raaulalonso/caseback/hardware/mechanical/renders/disc_puck_section.jpg

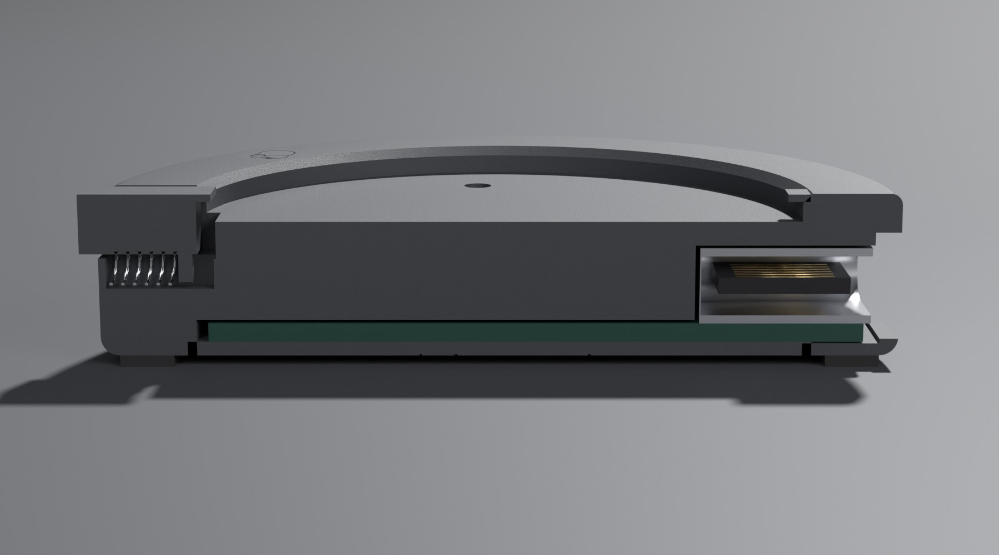
hardware/mechanical/renders/disc_puck_section.jpg
