raaulalonso/caseback/hardware/mechanical/renders/board_skin.jpg

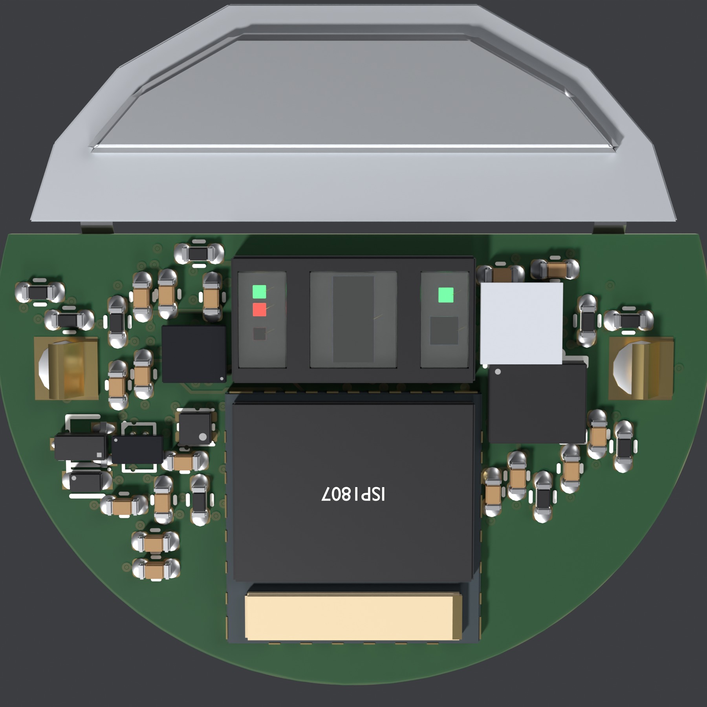
hardware/mechanical/renders/board_skin.jpg
