raaulalonso/caseback/apps/android/README.md

# Caseback Android (V2)

Native Android app (Kotlin + Jetpack Compose + Health Connect).

Out of scope for M0–M4. The iOS app is the V1 client. This package will consume `caseback-protocol` bindings.
