raaulalonso/caseback/hardware/mechanical/renders/band_buckle.jpg

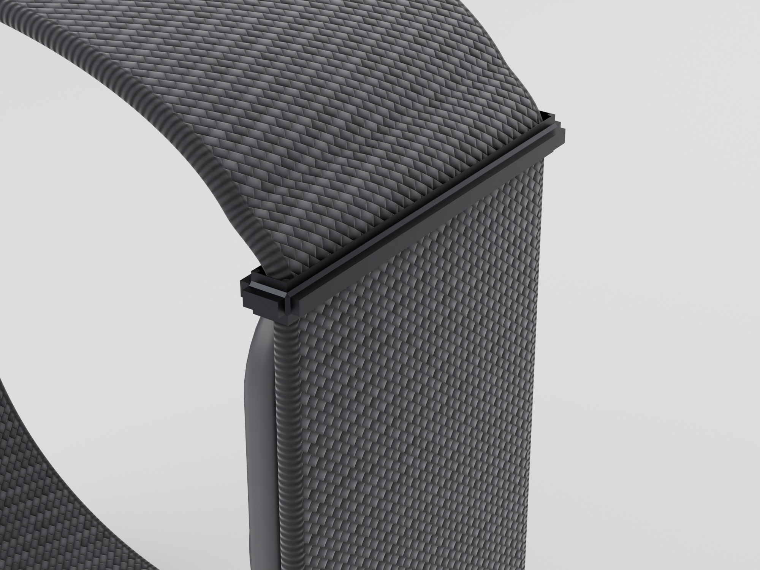
hardware/mechanical/renders/band_buckle.jpg
