raaulalonso/caseback/hardware/mechanical/renders/band_charging.jpg

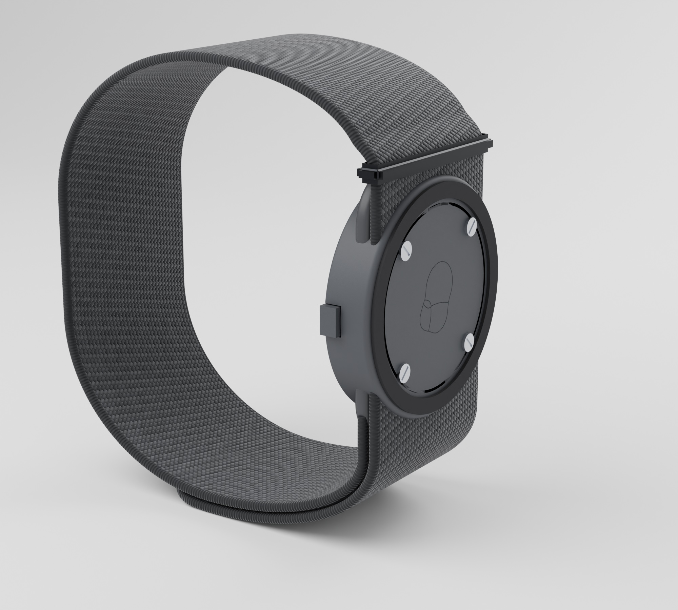
hardware/mechanical/renders/band_charging.jpg
