raaulalonso/caseback/hardware/mechanical/renders/band_hero.jpg

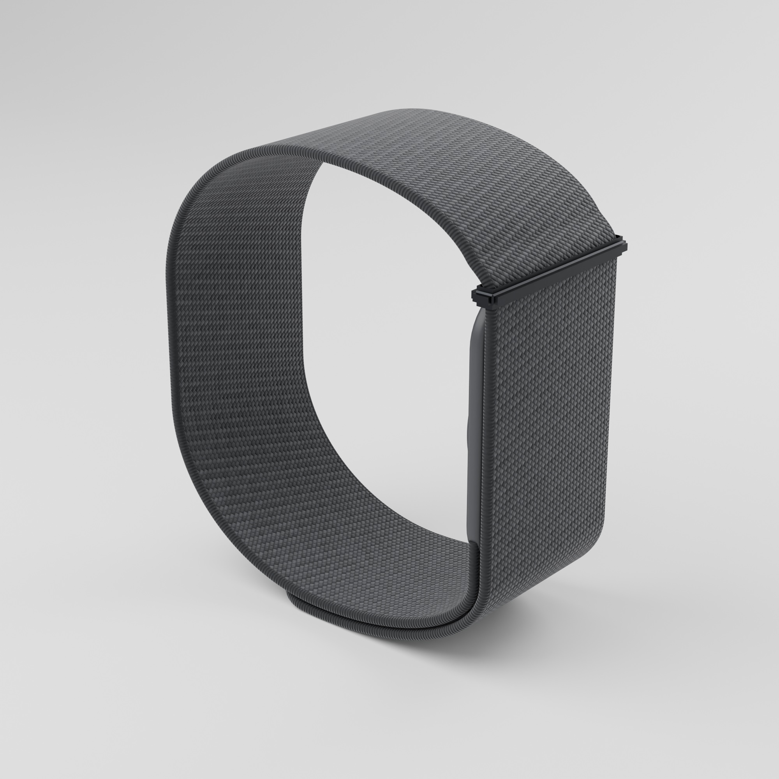
hardware/mechanical/renders/band_hero.jpg
