raaulalonso/caseback/hardware/mechanical/renders/band_holder.jpg

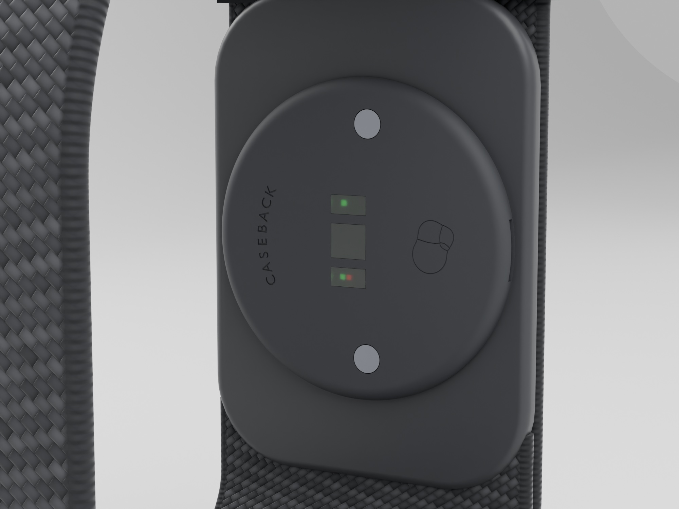
hardware/mechanical/renders/band_holder.jpg
