raaulalonso/caseback/hardware/mechanical/renders/band_inside.jpg

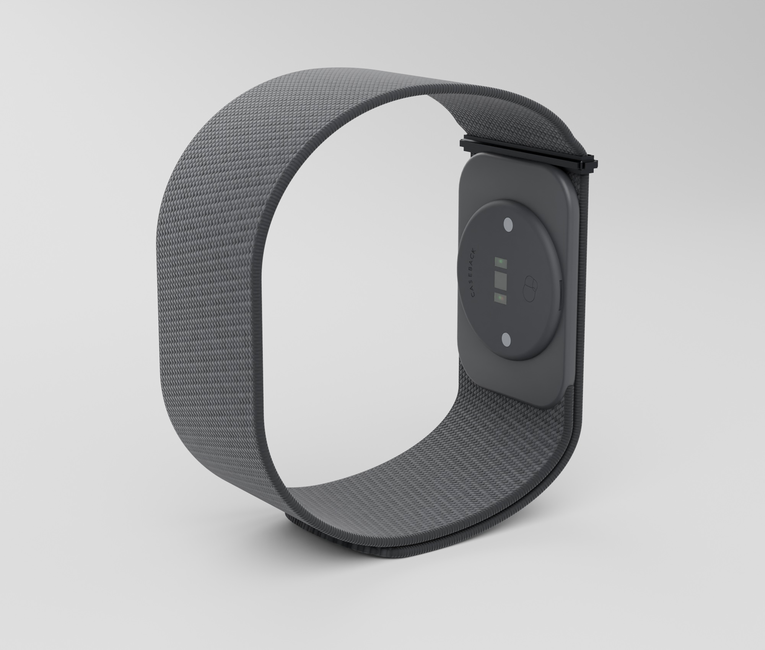
hardware/mechanical/renders/band_inside.jpg
