raaulalonso/caseback/hardware/mechanical/renders/band_open.jpg

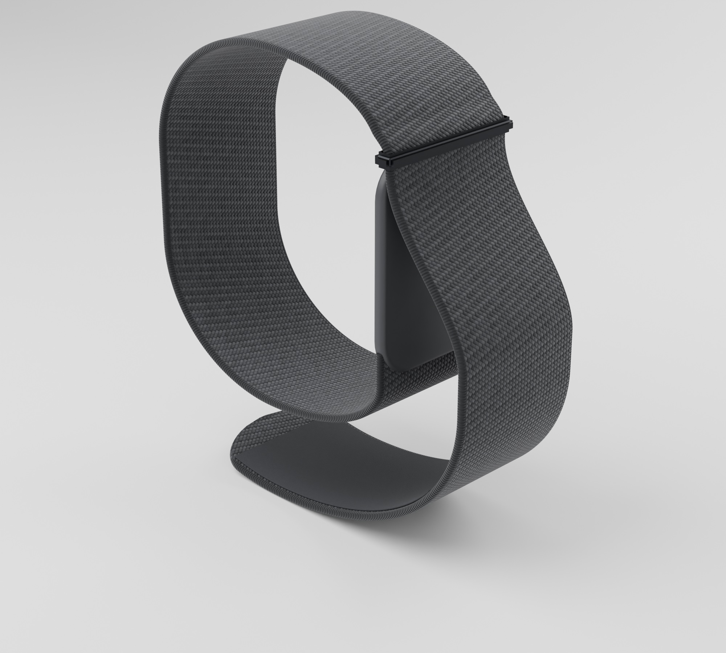
hardware/mechanical/renders/band_open.jpg
