raaulalonso/caseback/hardware/mechanical/renders/board_detail.jpg

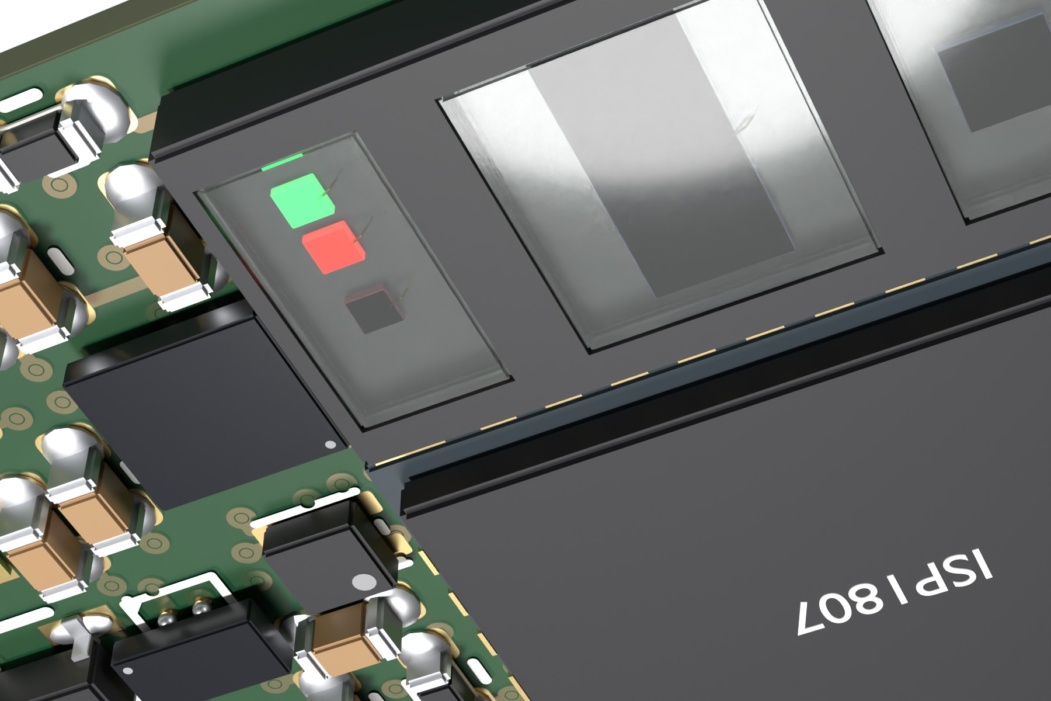
hardware/mechanical/renders/board_detail.jpg
