raaulalonso/caseback/hardware/mechanical/renders/board_oblique.jpg

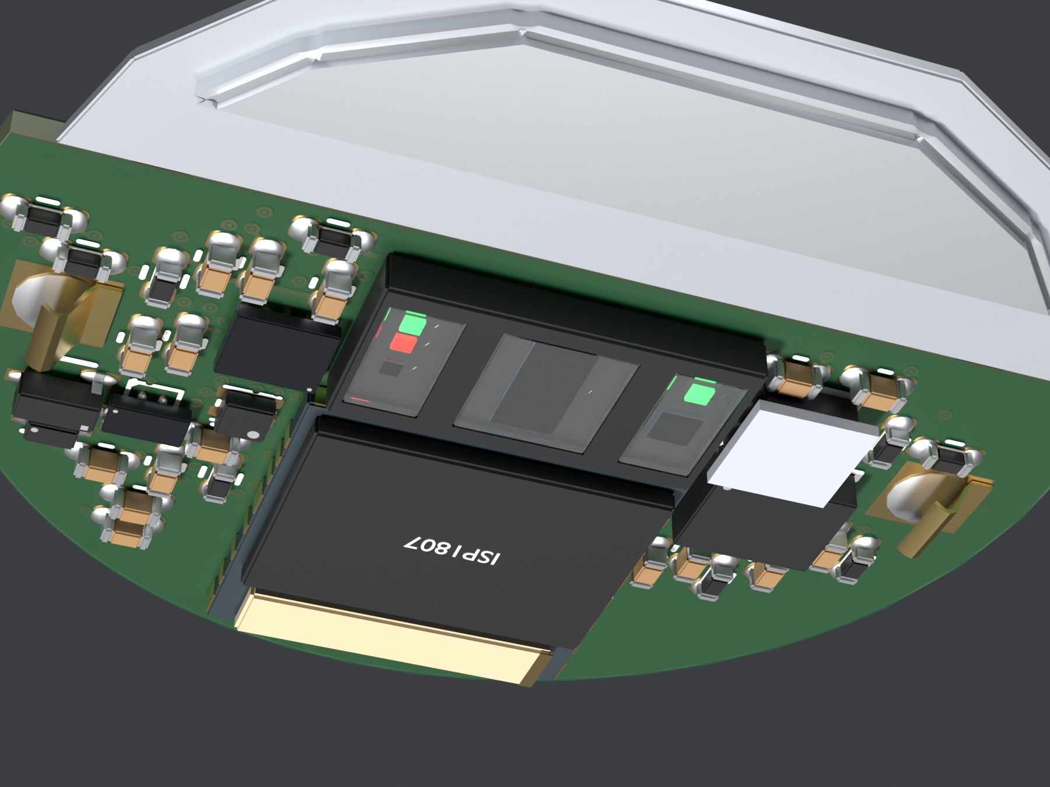
hardware/mechanical/renders/board_oblique.jpg
