raaulalonso/caseback/hardware/mechanical/renders/board_watch.jpg

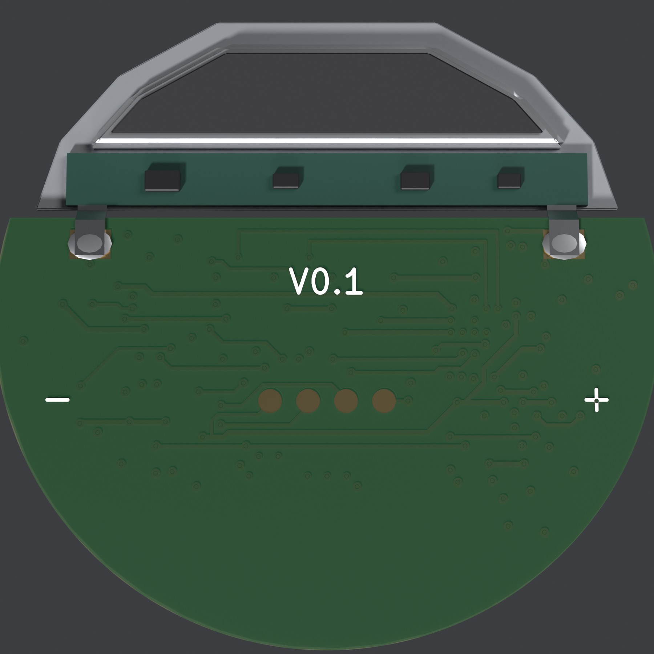
hardware/mechanical/renders/board_watch.jpg
