raaulalonso/caseback/hardware/mechanical/renders/disc_contact_section.jpg

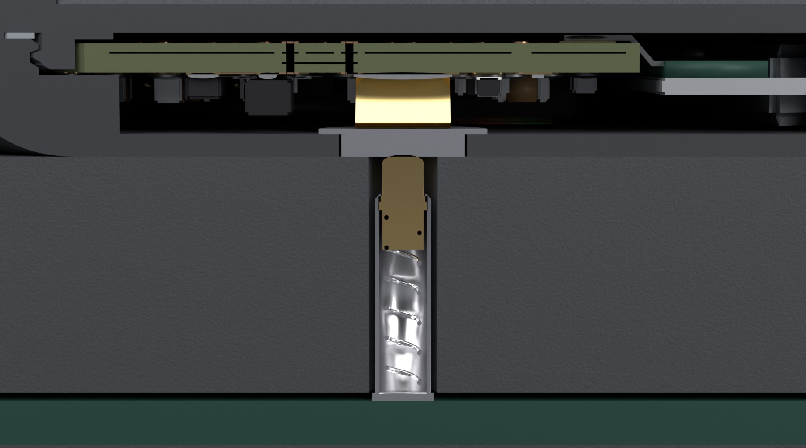
hardware/mechanical/renders/disc_contact_section.jpg
