raaulalonso/caseback/hardware/mechanical/renders/disc_docked.jpg

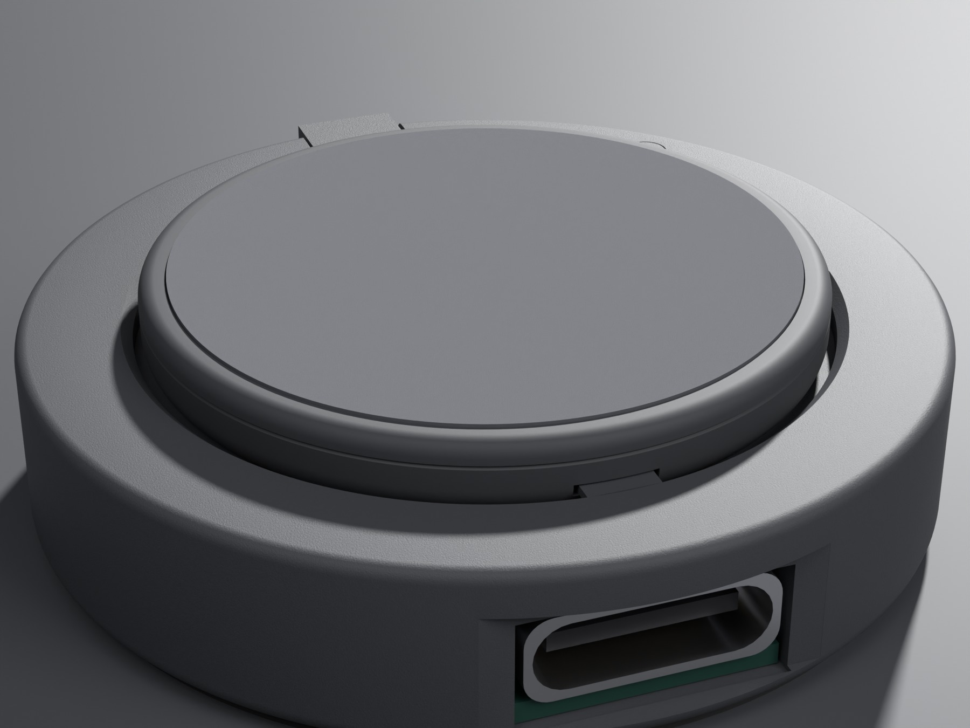
hardware/mechanical/renders/disc_docked.jpg
