raaulalonso/caseback/hardware/mechanical/renders/disc_docked_section.jpg

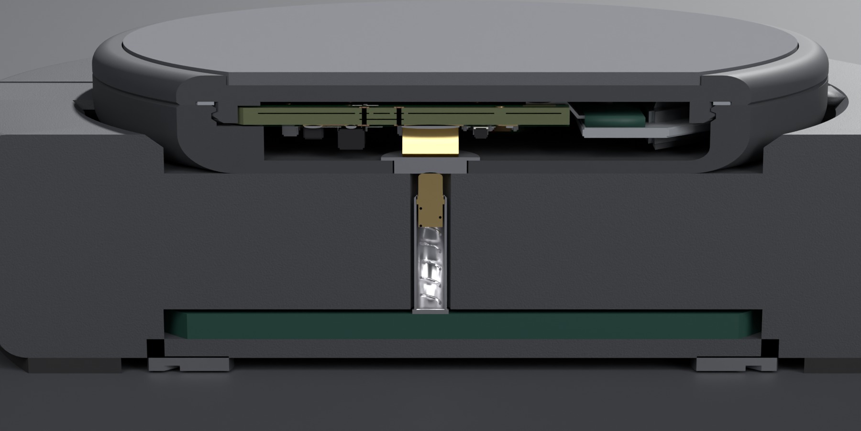
hardware/mechanical/renders/disc_docked_section.jpg
