raaulalonso/caseback/hardware/mechanical/renders/disc_edge.jpg

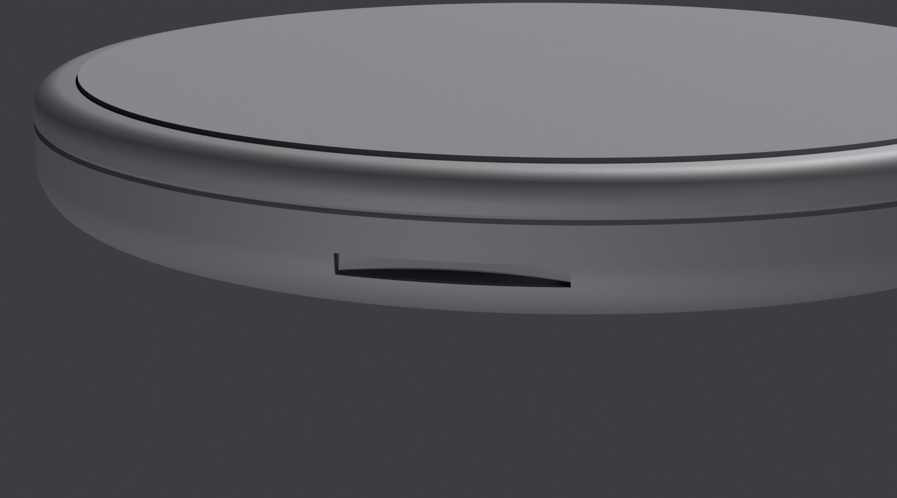
hardware/mechanical/renders/disc_edge.jpg
