raaulalonso/caseback/hardware/mechanical/renders/disc_edge_section.jpg

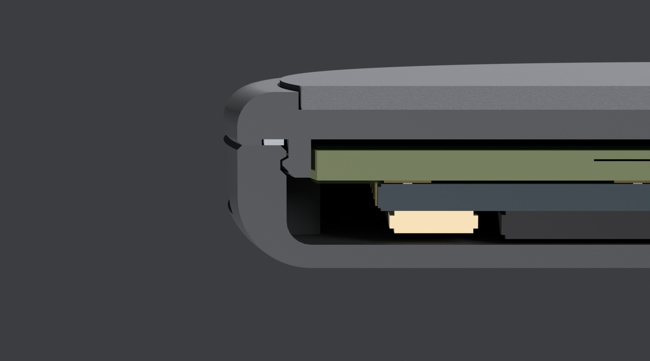
hardware/mechanical/renders/disc_edge_section.jpg
