raaulalonso/caseback/hardware/mechanical/renders/disc_exploded.jpg

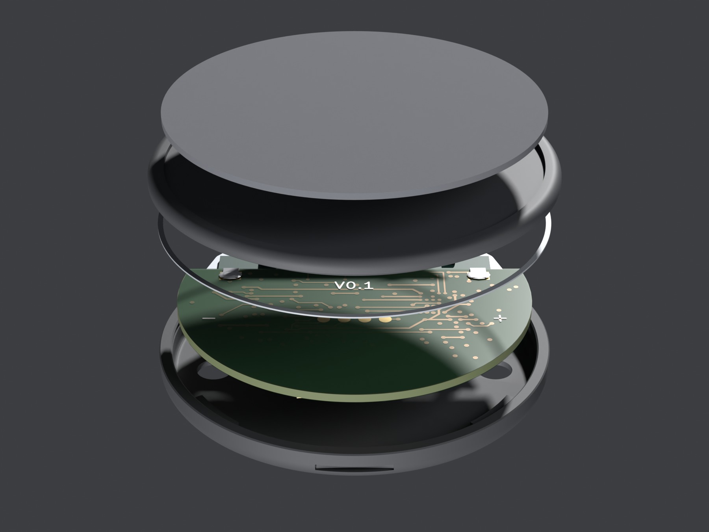
hardware/mechanical/renders/disc_exploded.jpg
