raaulalonso/caseback/hardware/mechanical/renders/disc_puck.jpg

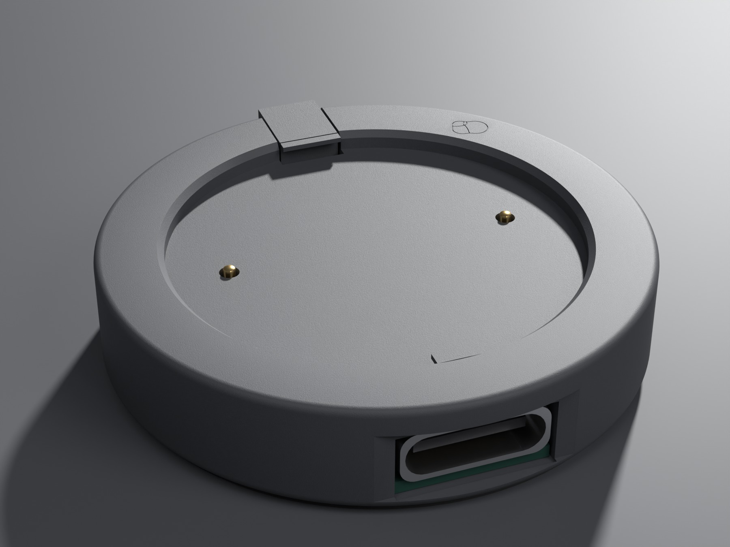
hardware/mechanical/renders/disc_puck.jpg
