raaulalonso/caseback/hardware/mechanical/renders/disc_puck_usb.jpg

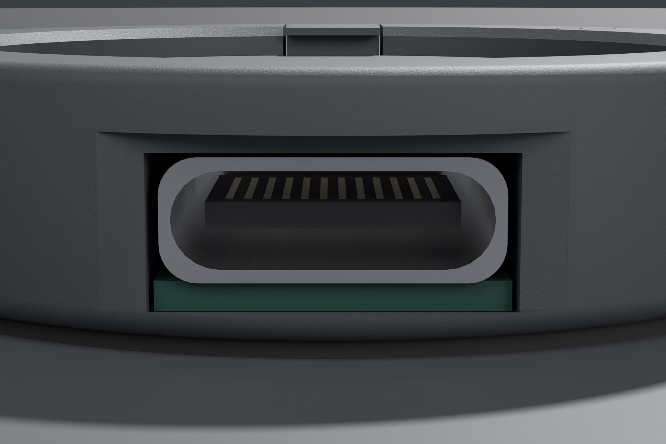
hardware/mechanical/renders/disc_puck_usb.jpg
