raaulalonso/caseback/hardware/mechanical/renders/disc_section.jpg

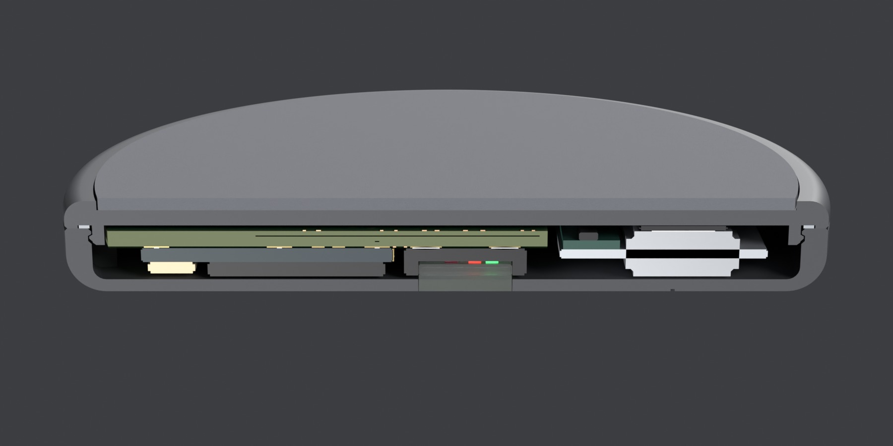
hardware/mechanical/renders/disc_section.jpg
