raaulalonso/caseback/hardware/mechanical/renders/disc_skin_contacts.jpg

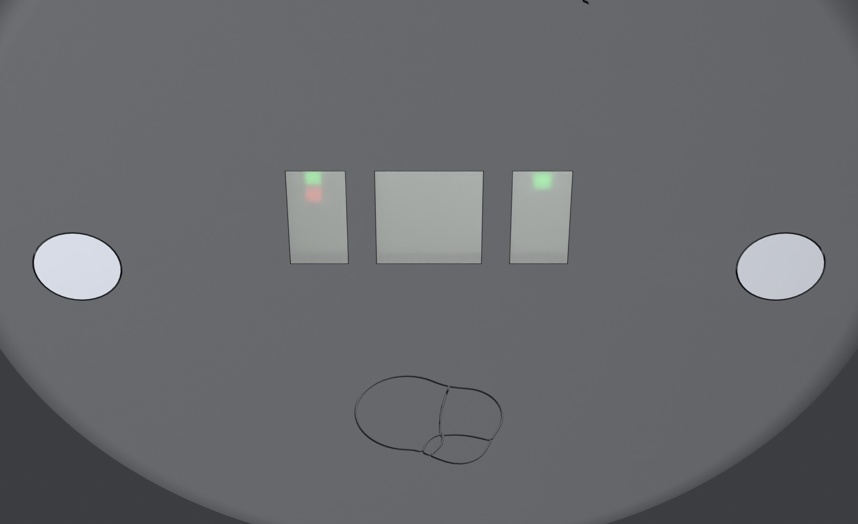
hardware/mechanical/renders/disc_skin_contacts.jpg
