raaulalonso/caseback/hardware/mechanical/renders/disc_skin_side.jpg

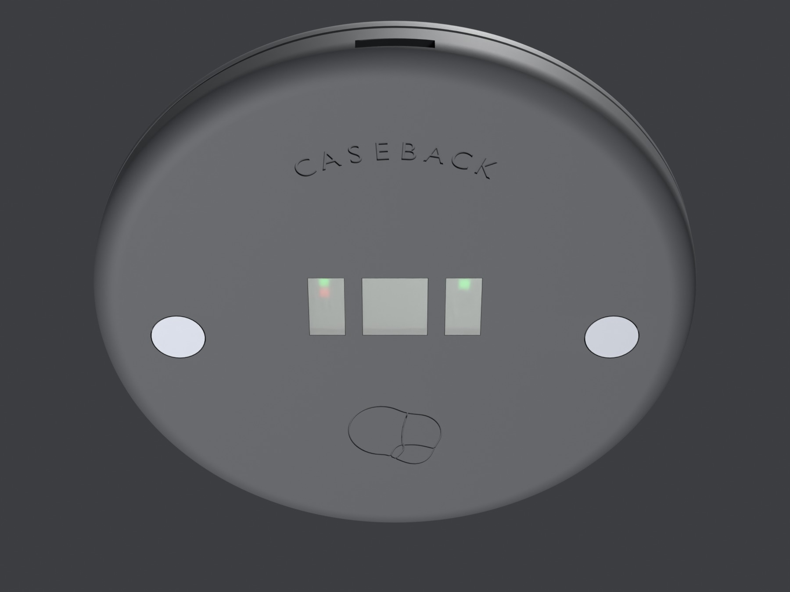
hardware/mechanical/renders/disc_skin_side.jpg
