raaulalonso/caseback/hardware/mechanical/renders/disc_watch_side.jpg

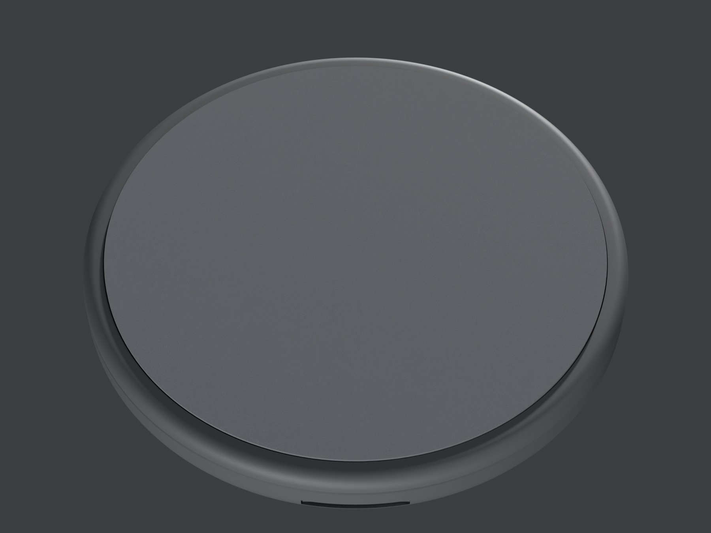
hardware/mechanical/renders/disc_watch_side.jpg
