raaulalonso/caseback/hardware/mechanical/renders/v1_exploded.png

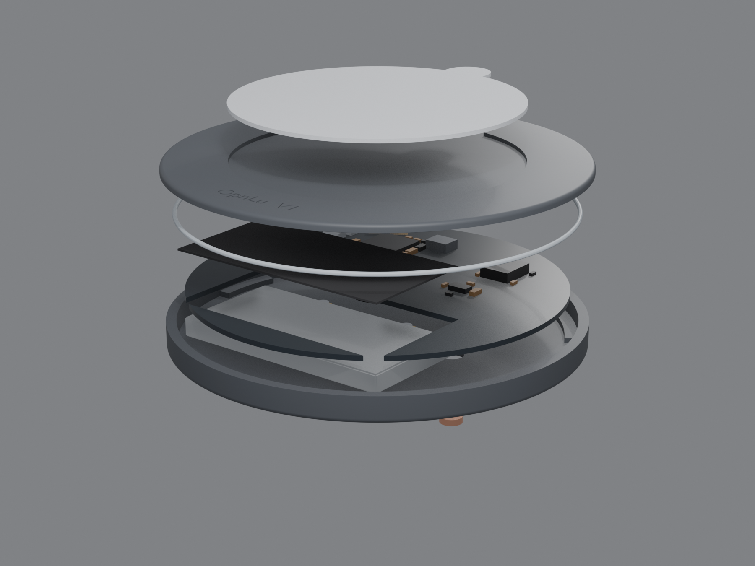
hardware/mechanical/renders/v1_exploded.png
