raaulalonso/caseback/hardware/mechanical/renders/v1_inside.png

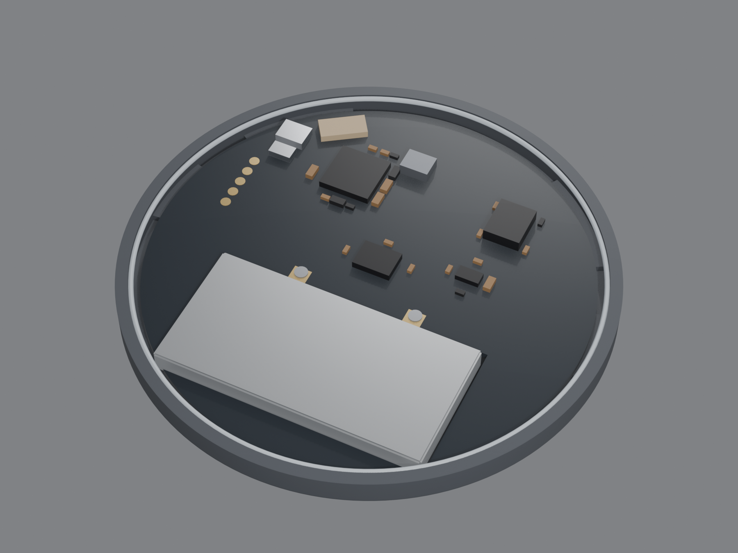
hardware/mechanical/renders/v1_inside.png
