raaulalonso/caseback/hardware/mechanical/renders/v1_section.png

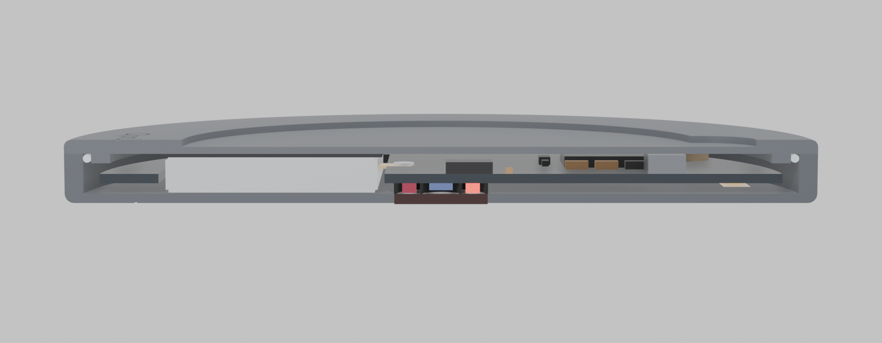
hardware/mechanical/renders/v1_section.png
