raaulalonso/caseback/hardware/mechanical/renders/v1_skin_side.png

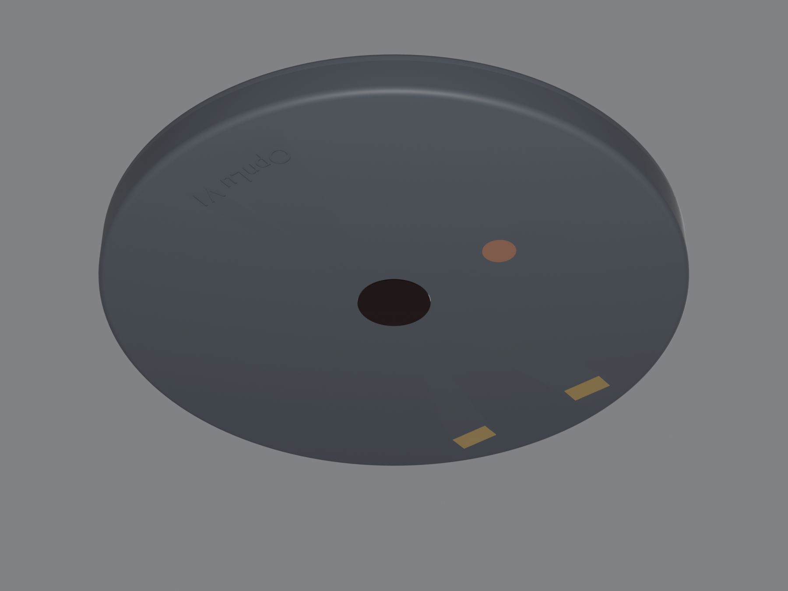
hardware/mechanical/renders/v1_skin_side.png
