raaulalonso/caseback/hardware/mechanical/renders/v1_watch_side.png

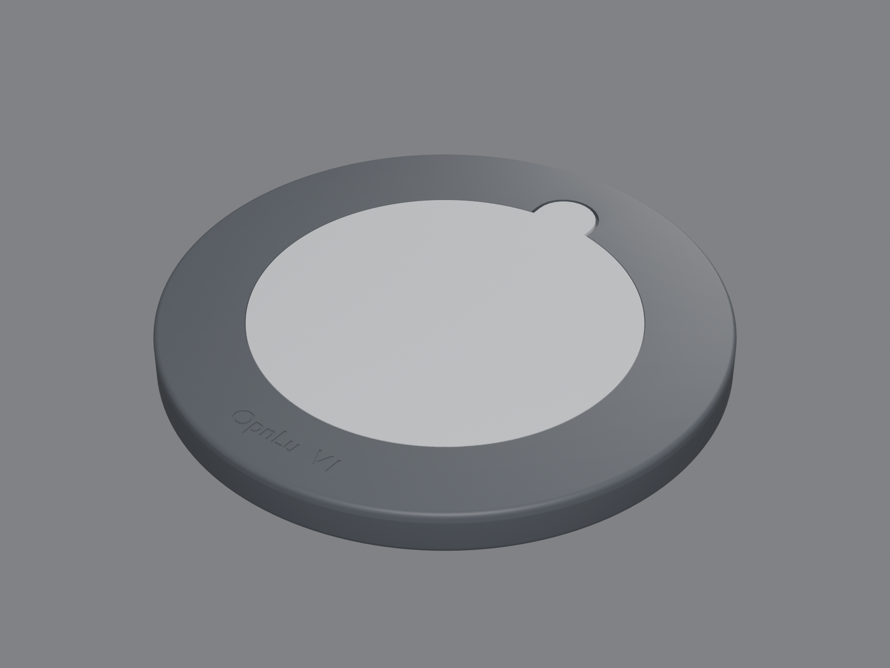
hardware/mechanical/renders/v1_watch_side.png
