raaulalonso/caseback/hardware/v1-pcb/drawings/board_v01_skin.png

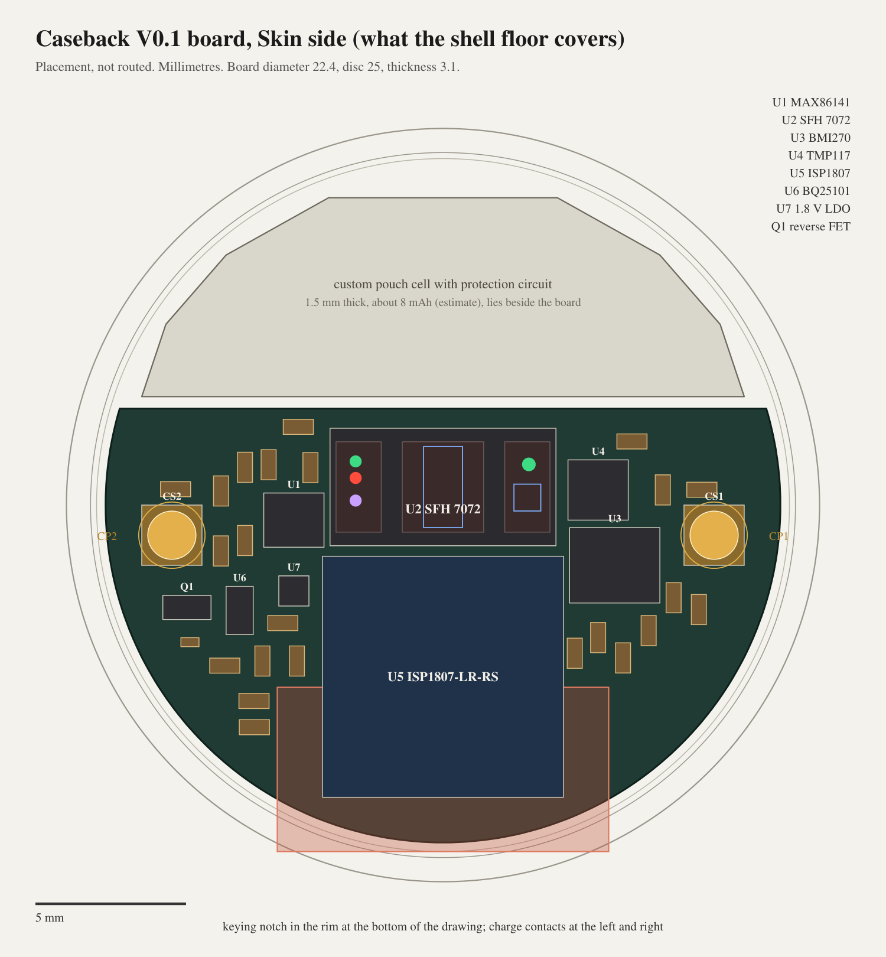
hardware/v1-pcb/drawings/board_v01_skin.png
