raaulalonso/caseback/hardware/v1-pcb/drawings/board_v01_watch.png

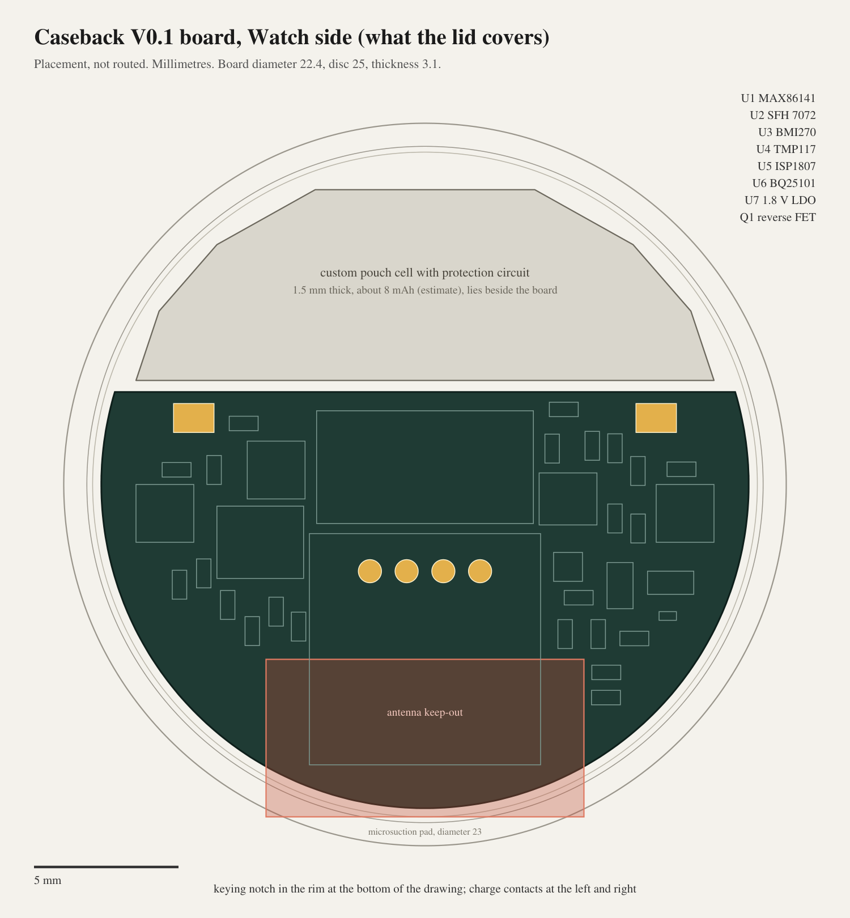
hardware/v1-pcb/drawings/board_v01_watch.png
