raaulalonso/caseback/hardware/v1-pcb/drawings/pcb_v01_skin.png

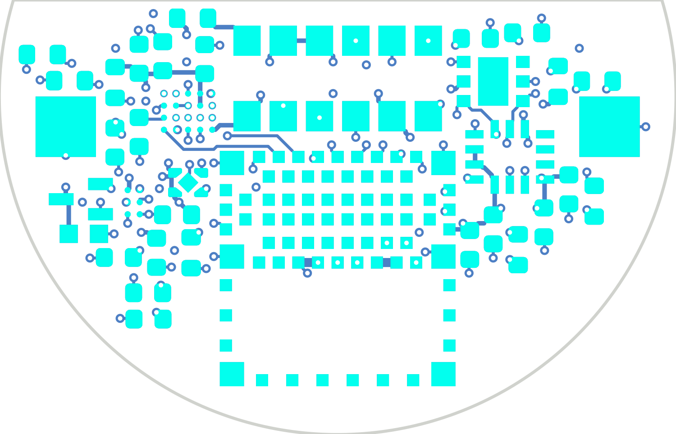
hardware/v1-pcb/drawings/pcb_v01_skin.png
