raaulalonso/caseback/hardware/v1-pcb/drawings/pcb_v01_watch.png

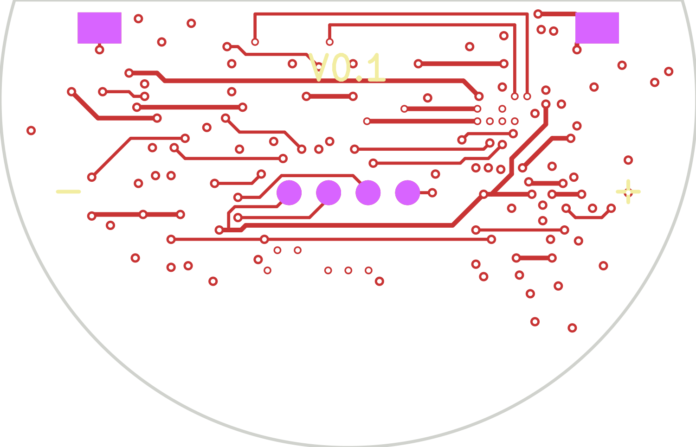
hardware/v1-pcb/drawings/pcb_v01_watch.png
