raaulalonso/caseback/hardware/v1-pcb/drawings/stack_v01.png

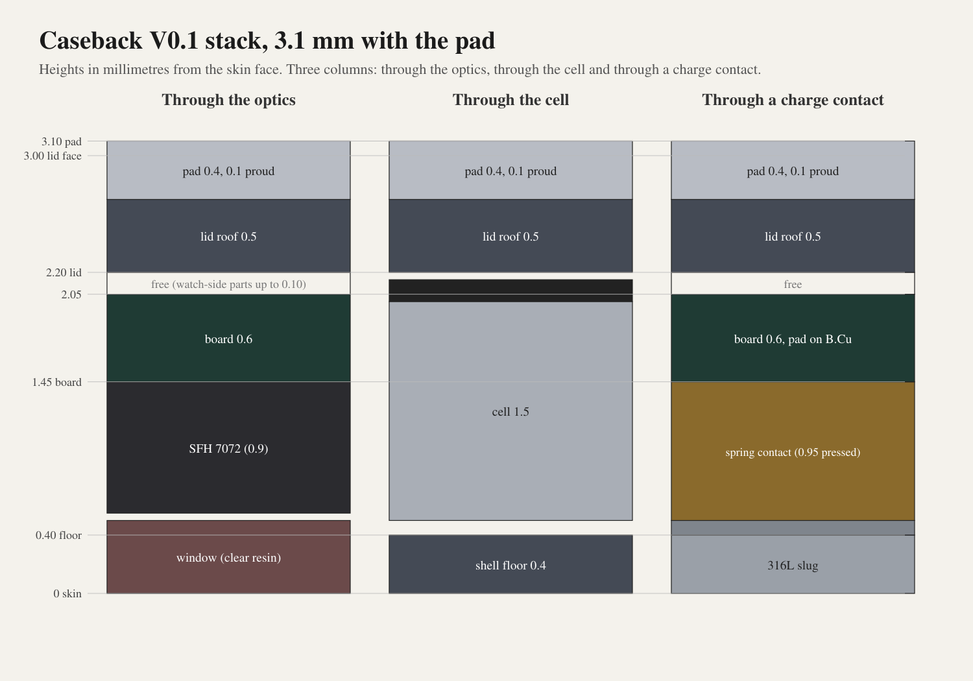
hardware/v1-pcb/drawings/stack_v01.png
