raaulalonso/caseback/tools/watch3d/leather_grain_normal.png

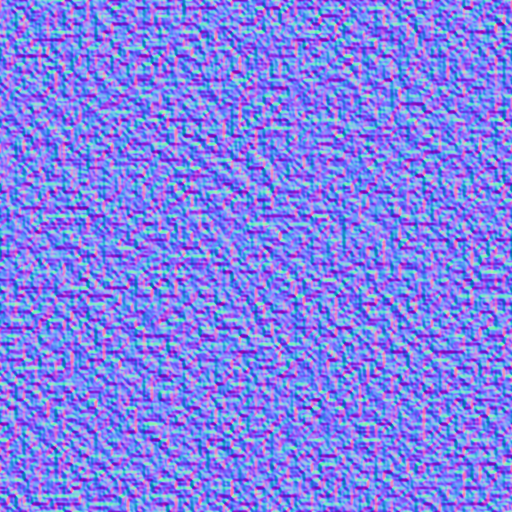
tools/watch3d/leather_grain_normal.png
