raaulalonso/caseback/hardware/v1-pcb/kicad/fab/caseback_v01_bom.csv

Comment | Designator | Footprint | LCSC Part #
100n F | C1,C4,C6,C7,C8,C9,C15,C16 | 0402 | C1525
1u F | C3,C10,C12,C13 | 0402 | C52923
2.2u F | C11 | 0402 | C12530
4.7u F | C14 | 0402 | C23733
10u F | C2,C5 | 0402 | C15525
TPD1E10B06DPYR | D1 | X1SON-2 | C48260
DMG1013T-7 | Q1 | SC-75-3 | C96676
2.2 ohm | R1,R2 | 0402 | C25101
4.7k ohm | R3,R4 | 0402 | C25900
100k ohm | R5 | 0402 | C25741
13k ohm | R6 | 0402 | C25754
10k ohm | R7 | 0402 | C25744
1M ohm | R8 | 0402 | C26083
750k ohm | R9 | 0402 | C122545
MAX86141ENP+T | U1 | BGA-20 | C5328762
SFH 7072 | U2 | DFN-12 | C2655172
BMI270 | U3 | LGA-14 | C2836813
TMP117MAIDRVR | U4 | WSON-6 | C2803242
ISP1807-LR-RS | U5 | BULETM-SMD | C5264268
BQ25101YFPR | U6 | DSBGA-6 | C478468
TLV75518PDQNR | U7 | X2SON-4 | C2867154
