raaulalonso/caseback/hardware/mechanical/print/caseback_mock_pad.stl

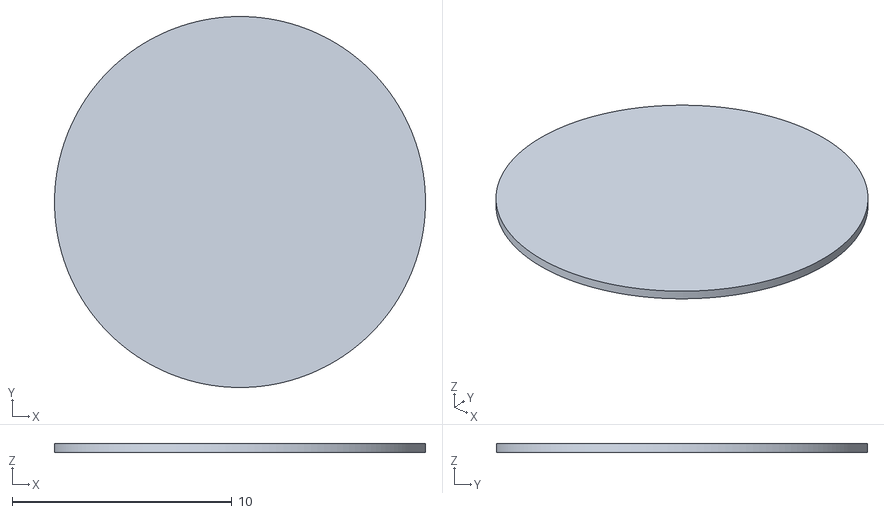
[picture p35: CAD file, 2026-10-29]
hardware/mechanical/print/caseback_mock_pad.stl
16.9 x 16.9 x 0.4
