raaulalonso/caseback/hardware/mechanical/stl/disc_shell.stl

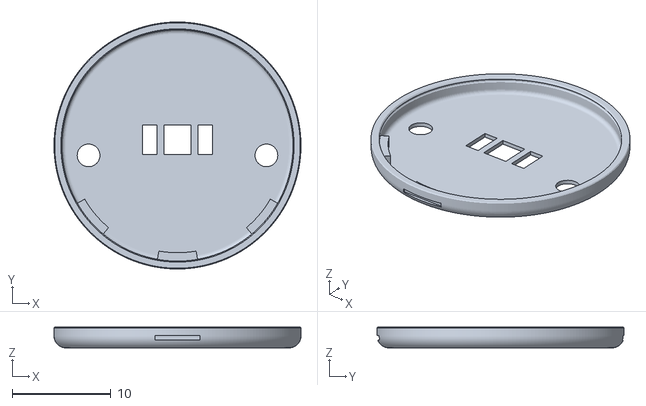
[picture p36: CAD file, 2026-10-30]
hardware/mechanical/stl/disc_shell.stl
25.0 x 25.0 x 2.10
