raaulalonso/caseback/hardware/mechanical/print/caseback_mock_lid_easy.stl

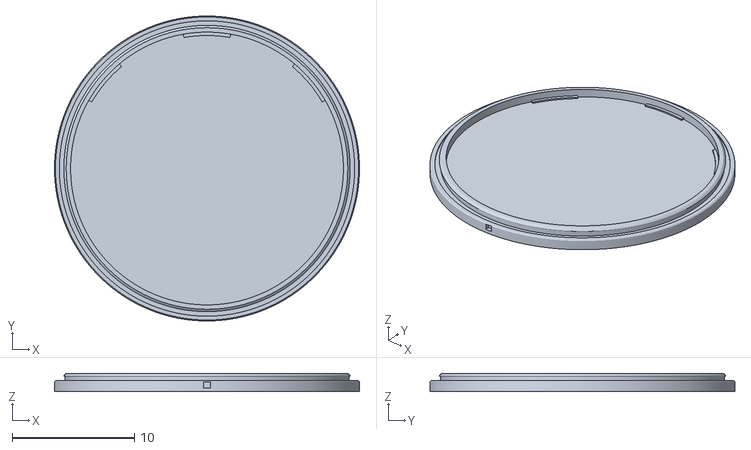
[picture p37: CAD file, 2026-10-29]
hardware/mechanical/print/caseback_mock_lid_easy.stl
25.0 x 25.0 x 1.50
