raaulalonso/caseback/hardware/mechanical/stl/disc_fit_dummy.stl

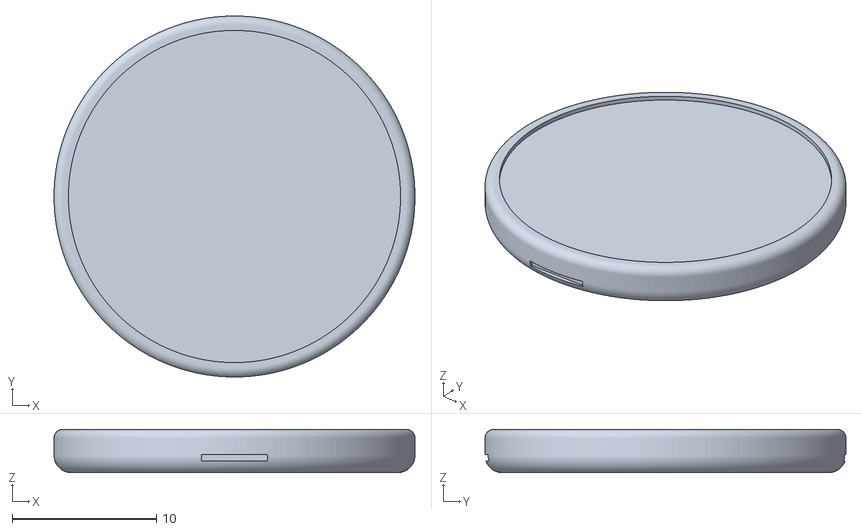
[picture p38: CAD file, 2026-10-30]
hardware/mechanical/stl/disc_fit_dummy.stl
25.0 x 25.0 x 3.00
