raaulalonso/caseback/hardware/mechanical/print/caseback_mock_puck_A1_PETG.3mf

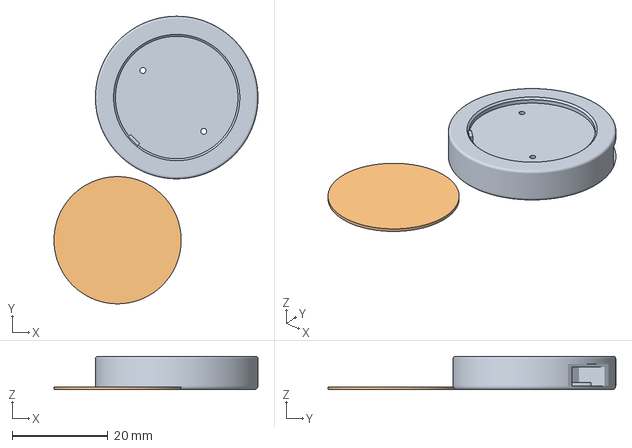
[picture p39: CAD file, 2026-10-29]
hardware/mechanical/print/caseback_mock_puck_A1_PETG.3mf
42.7 x 60.1 x 7.00 mm
caseback_mock_puck_body.stl
caseback_mock_puck_plate.stl
