raaulalonso/caseback/hardware/mechanical/stl/puck_latch.stl

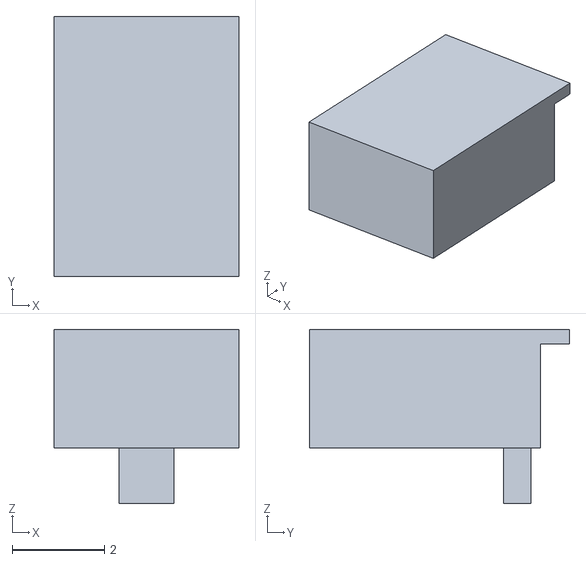
[picture p40: CAD file, 2026-10-30]
hardware/mechanical/stl/puck_latch.stl
4.00 x 5.63 x 3.77
