raaulalonso/caseback/hardware/mechanical/stl/band_buckle.stl

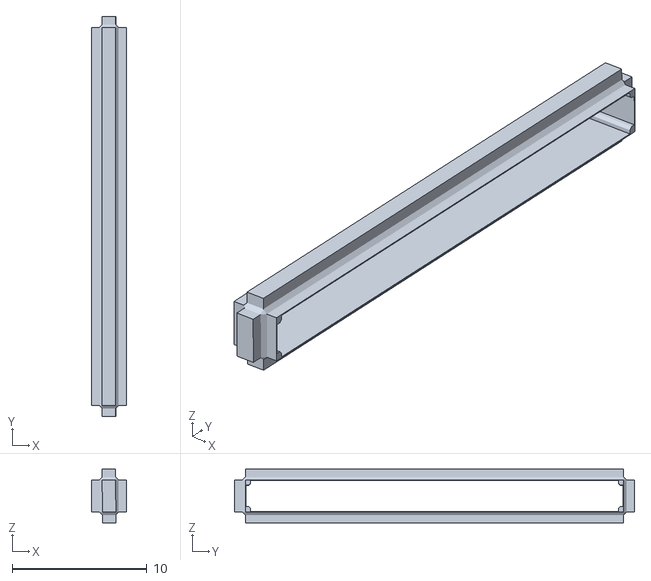
[picture p41: CAD file, 2026-10-30]
hardware/mechanical/stl/band_buckle.stl
2.61 x 29.7 x 4.00
