raaulalonso/caseback/hardware/mechanical/print/caseback_mock_puck_body.stl

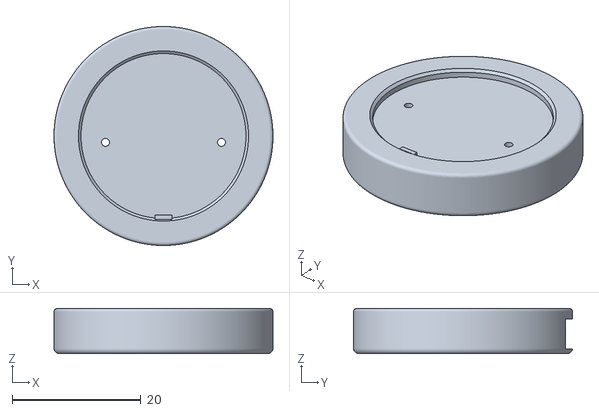
[picture p42: CAD file, 2026-10-29]
hardware/mechanical/print/caseback_mock_puck_body.stl
34.0 x 34.0 x 7.00
