raaulalonso/caseback/hardware/mechanical/stl/band_holder.stl

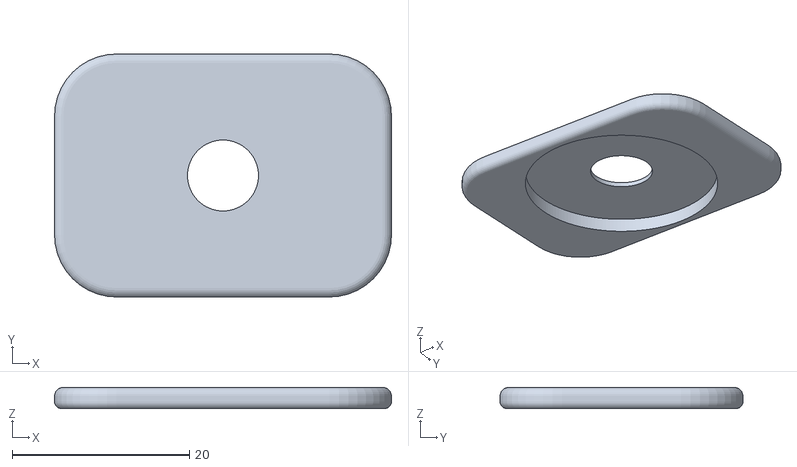
[picture p43: CAD file, 2026-10-30]
hardware/mechanical/stl/band_holder.stl
38.0 x 27.4 x 2.40
