raaulalonso/caseback/hardware/mechanical/print/caseback_mock_puck_plate.stl

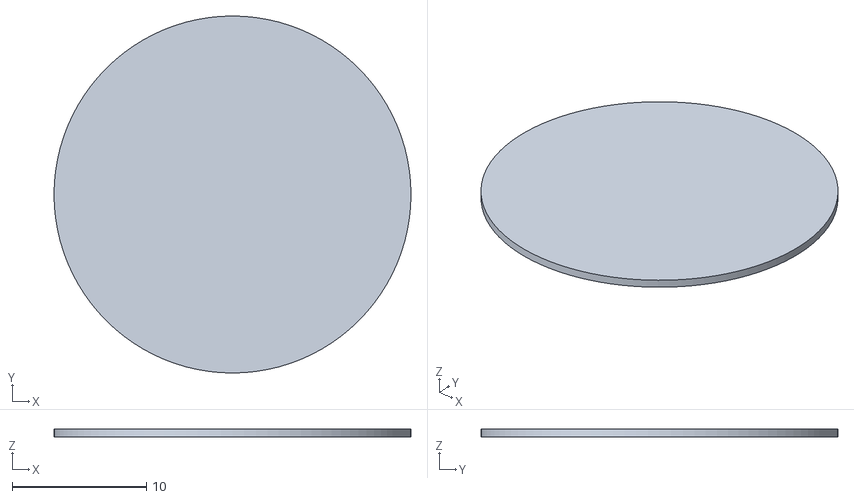
[picture p44: CAD file, 2026-10-29]
hardware/mechanical/print/caseback_mock_puck_plate.stl
26.6 x 26.6 x 0.6
