raaulalonso/caseback/hardware/mechanical/print/caseback_mock_A1_PETG.3mf

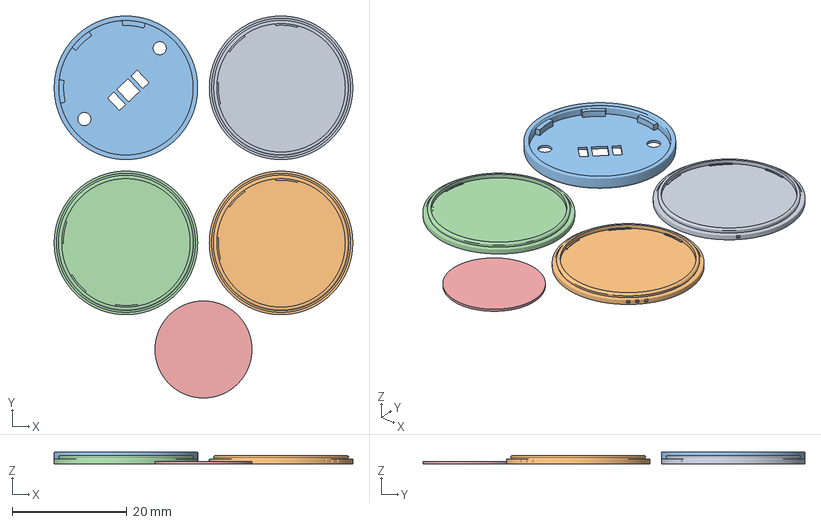
[picture p45: CAD file, 2026-10-29]
hardware/mechanical/print/caseback_mock_A1_PETG.3mf
52.0 x 66.5 x 2.10 mm
caseback_mock_lid_easy.stl
caseback_mock_lid_firm.stl
caseback_mock_shell.stl
caseback_mock_lid_standard.stl
caseback_mock_pad.stl
