raaulalonso/caseback/hardware/mechanical/stl/puck_hook.stl

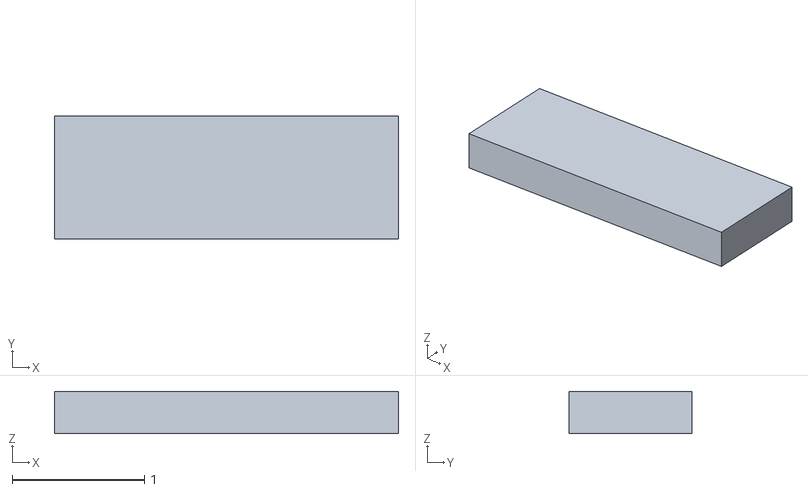
[picture p46: CAD file, 2026-10-30]
hardware/mechanical/stl/puck_hook.stl
2.60 x 0.93 x 0.32
