raaulalonso/caseback/hardware/mechanical/stl/caseback_v0_band.stl

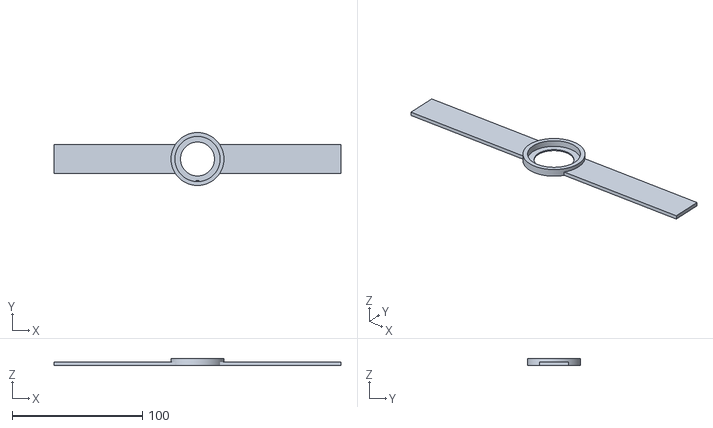
[picture p47: CAD file, 2026-10-29]
hardware/mechanical/stl/caseback_v0_band.stl
220.0 x 40.6 x 5.00
