raaulalonso/caseback/hardware/mechanical/stl/puck_key.stl

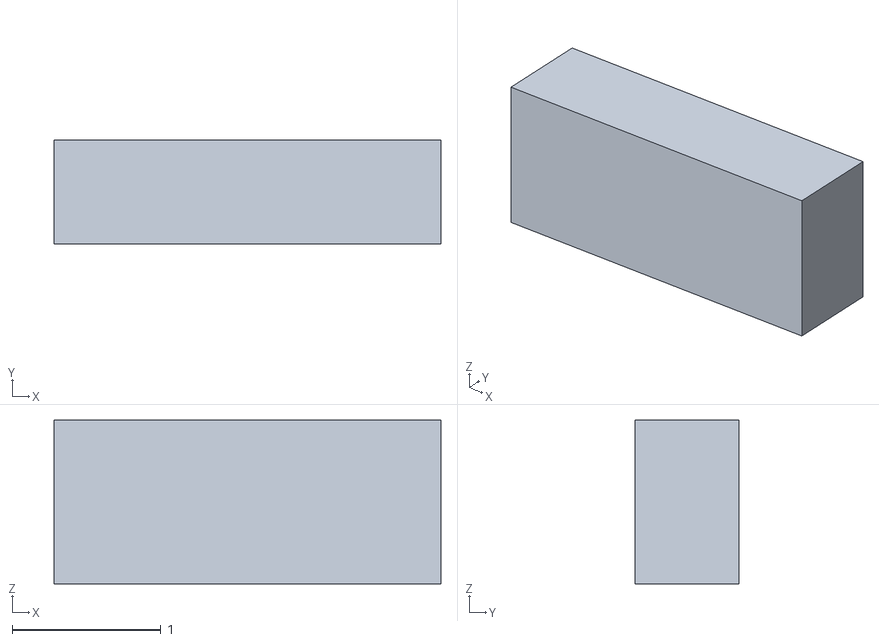
[picture p48: CAD file, 2026-10-29]
hardware/mechanical/stl/puck_key.stl
2.60 x 0.7 x 1.10
