raaulalonso/caseback/hardware/mechanical/stl/caseback_v0_top.stl

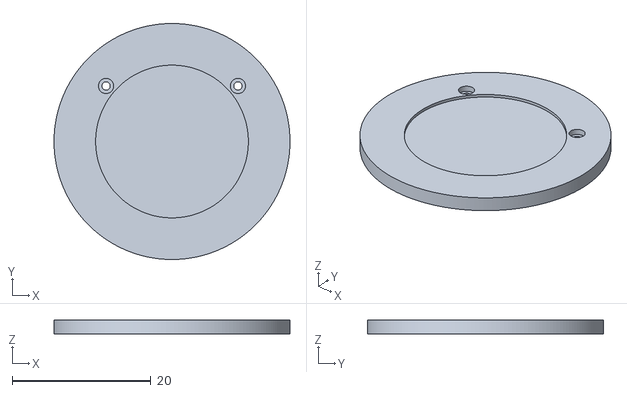
[picture p49: CAD file, 2026-10-29]
hardware/mechanical/stl/caseback_v0_top.stl
34.0 x 34.0 x 2.00
