raaulalonso/caseback/hardware/mechanical/stl/caseback_v0_bottom.stl

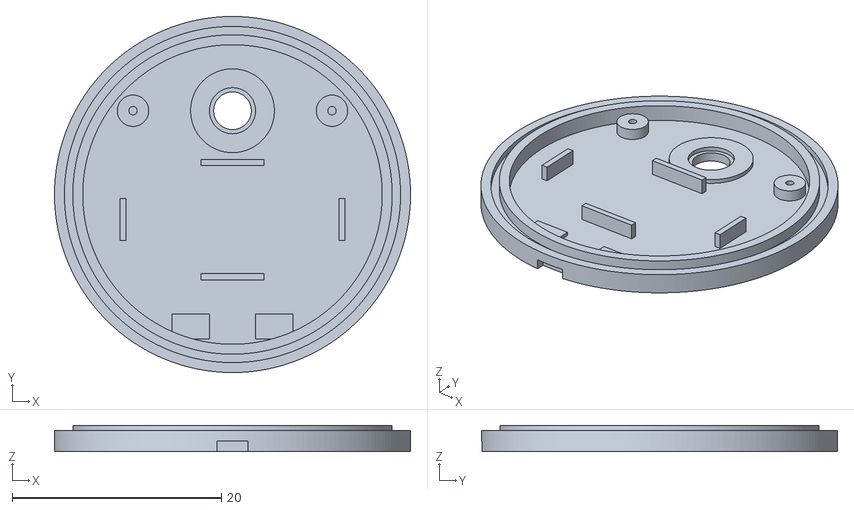
[picture p50: CAD file, 2026-10-29]
hardware/mechanical/stl/caseback_v0_bottom.stl
34.0 x 34.0 x 2.50
