raaulalonso/caseback/hardware/mechanical/stl/caseback_v0_puck.stl

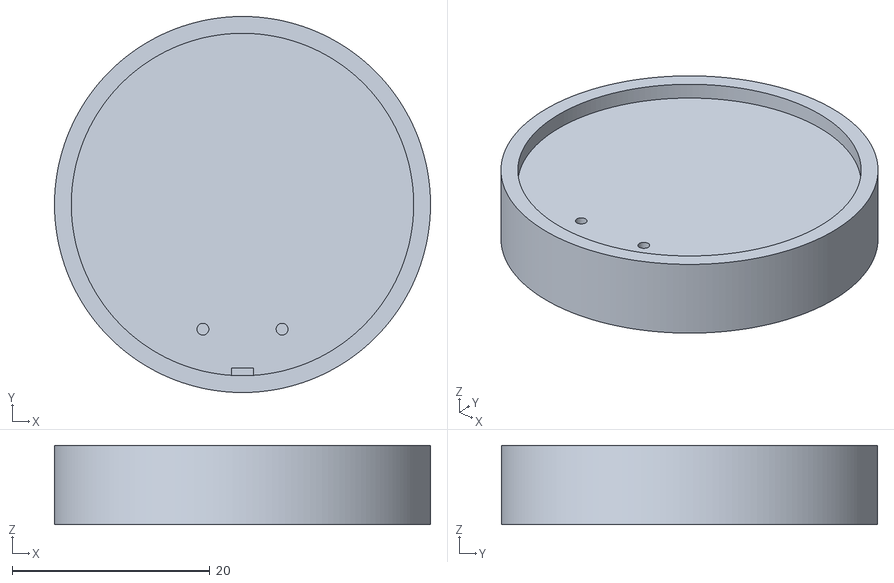
[picture p51: CAD file, 2026-10-29]
hardware/mechanical/stl/caseback_v0_puck.stl
38.0 x 38.0 x 8.00
