raaulalonso/caseback/(list of files, cad)

Other CAD files:
hardware/mechanical/print/caseback_mock_lid_standard.stl
hardware/mechanical/stl/puck_body.stl
hardware/mechanical/print/caseback_mock_lid_firm.stl
hardware/mechanical/stl/disc_lid.stl
hardware/mechanical/print/caseback_mock_shell.stl
hardware/mechanical/stl/puck_base_plate.stl
hardware/mechanical/scripts/caseback_v0_mechanical.blend
hardware/mechanical/scripts/caseback_v1_concept.blend
tools/watch3d/CasebackWatch.blend
