raaulalonso/caseback/hardware/v1-pcb/kicad/caseback_v01.kicad_pcb

## KiCad design hardware/v1-pcb/kicad/caseback_v01.kicad_pcb (2026-10-29)

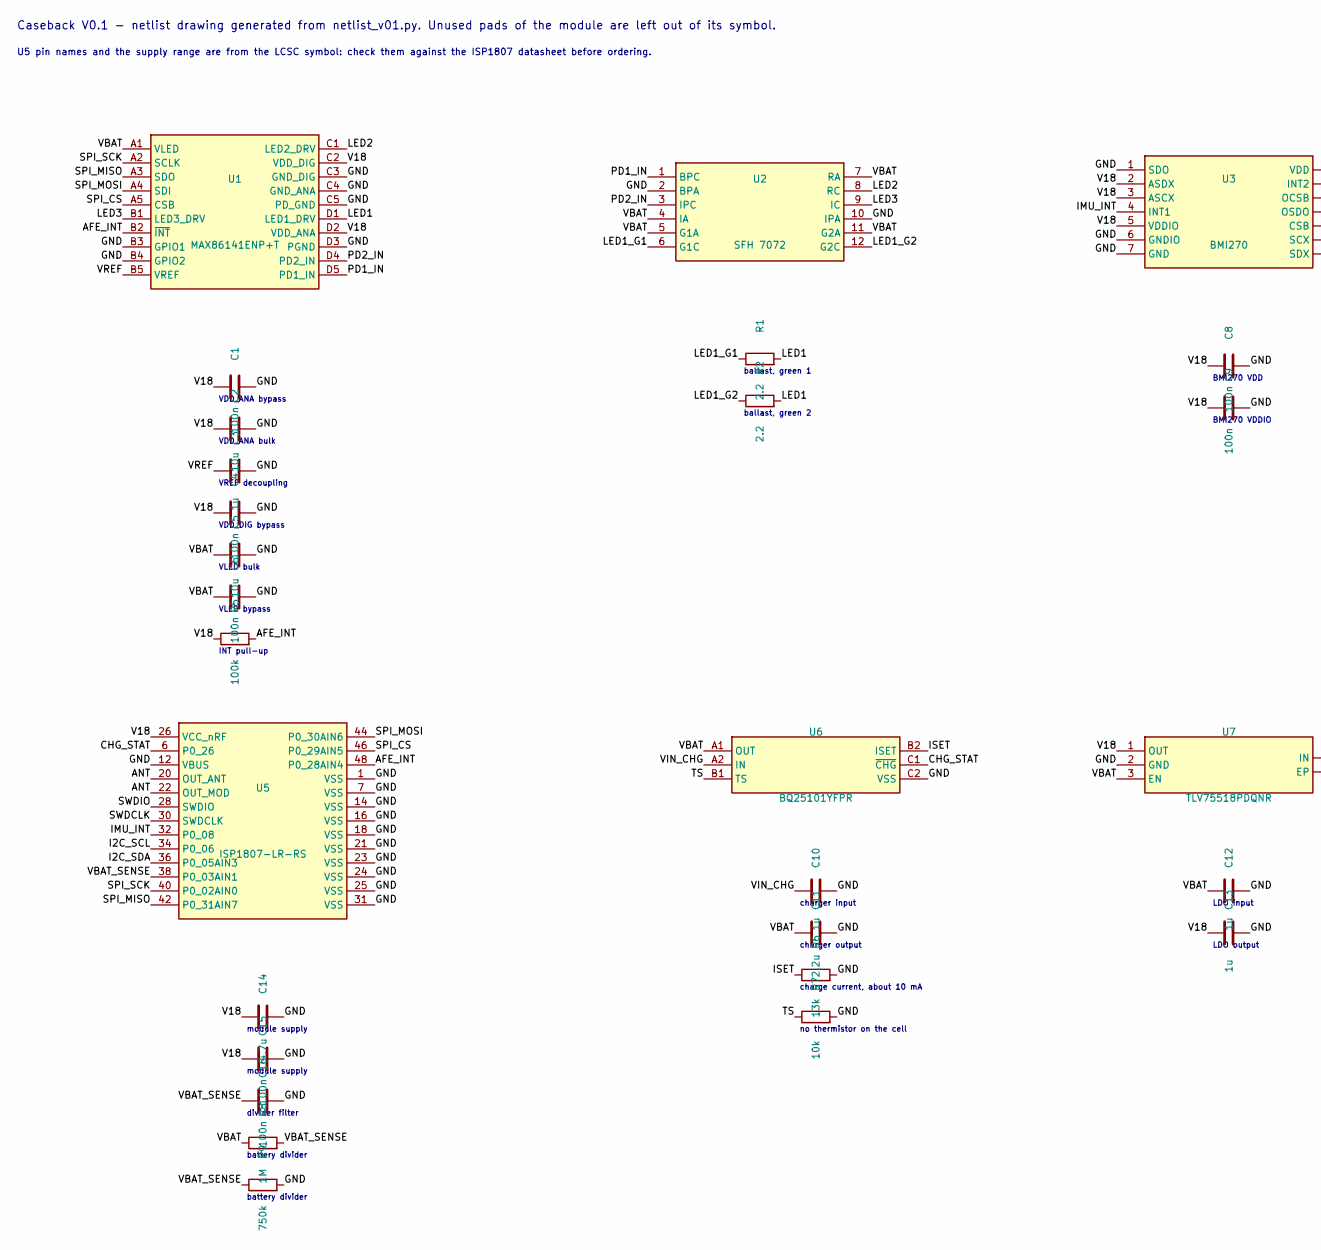
[picture p52: schematic caseback_v01.kicad_sch, Caseback V0.1, part in row 1, column 1]

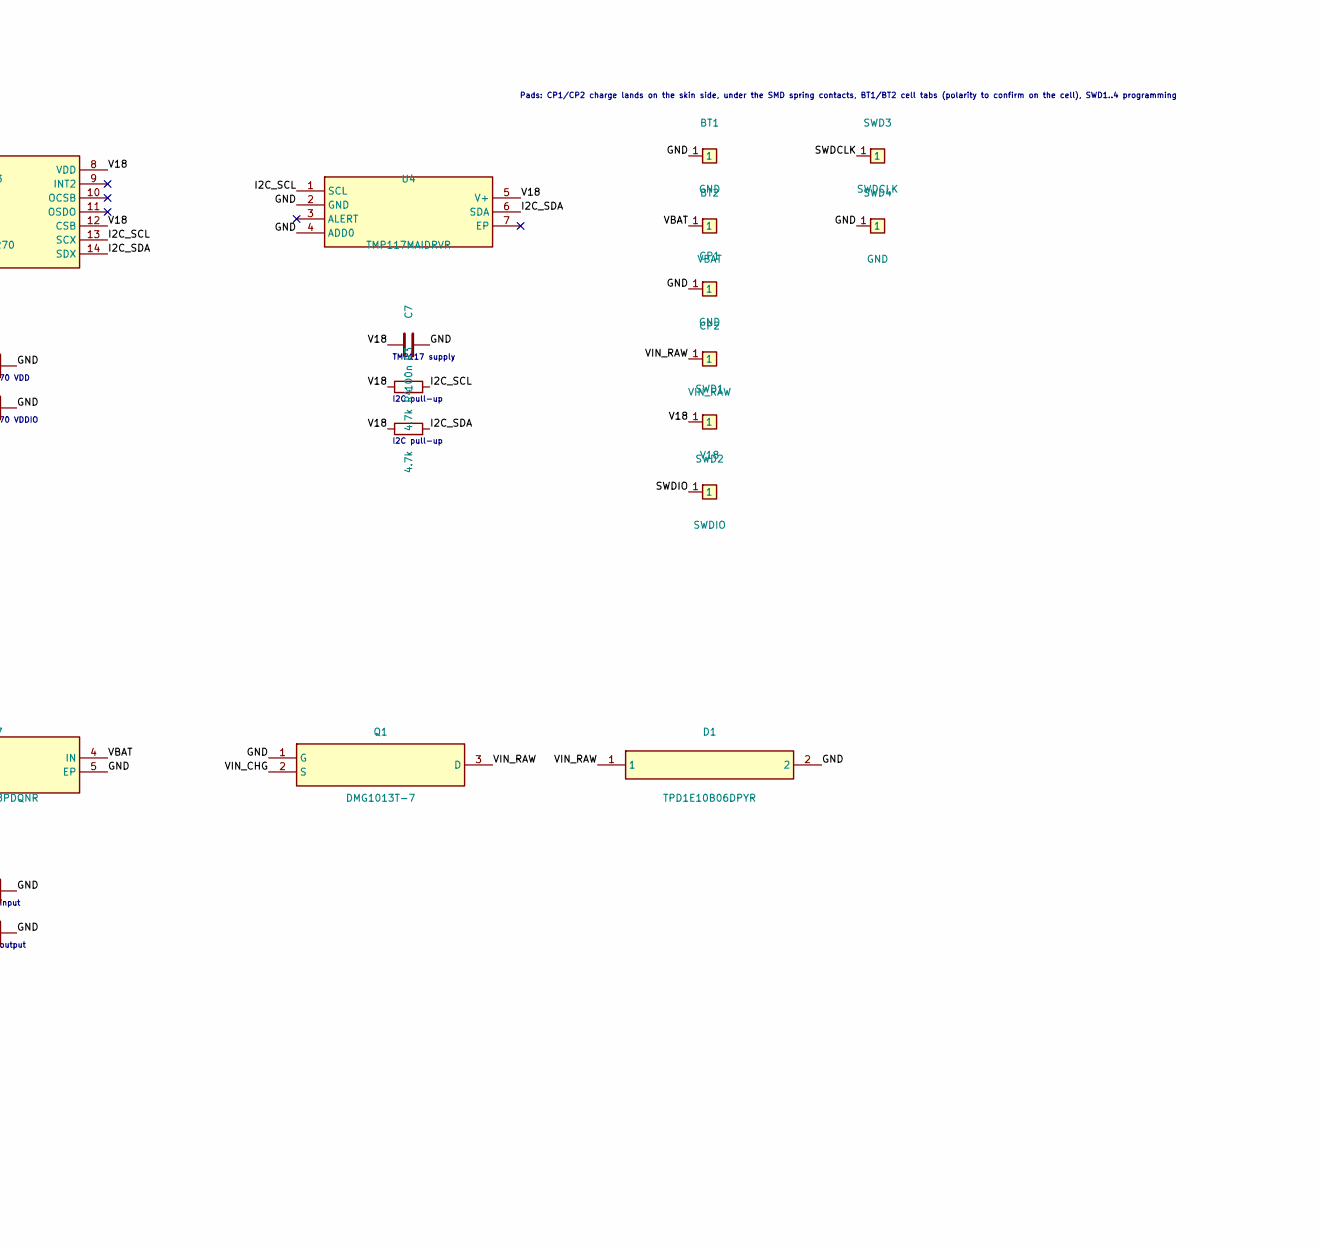
[picture p53: schematic caseback_v01.kicad_sch, Caseback V0.1, part in row 1, column 2]

Parts:
BT1: GND; pad
BT2: VBAT; pad
C1, C4, C6, C7, C8, C9, C15, C16: 100n; 0402; LCSC C1525
C2, C5: 10u; 0402; LCSC C15525
C3, C10, C12, C13: 1u; 0402; LCSC C52923
C11: 2.2u; 0402; LCSC C12530
C14: 4.7u; 0402; LCSC C23733
CP1: GND; pad
CP2: VIN_RAW; pad
D1: TPD1E10B06DPYR; X1SON-2_L1.0-W0.6-P0.65-BI-1; LCSC C48260
Q1: DMG1013T-7; SC-75-3_L1.6-W0.8-P1.00-LS1.6-BR; LCSC C96676
R1, R2: 2.2; 0402; LCSC C25101
R3, R4: 4.7k; 0402; LCSC C25900
R5: 100k; 0402; LCSC C25741
R6: 13k; 0402; LCSC C25754
R7: 10k; 0402; LCSC C25744
R8: 1M; 0402; LCSC C26083
R9: 750k; 0402; LCSC C122545
SWD1: V18; pad
SWD2: SWDIO; pad
SWD3: SWDCLK; pad
SWD4: GND; pad
U1: MAX86141ENP+T; BGA-20_L2.0-W1.8-R4-C5-P0.40-TL; LCSC C5328762
U2: SFH 7072; DFN-12_L7.5-W3.9-P1.20-BL; LCSC C2655172
U3: BMI270; LGA-14_L3.0-W2.5-P0.50-BR; LCSC C2836813
U4: TMP117MAIDRVR; WSON-6_L2.0-W2.0-P0.65-BL-EP; LCSC C2803242
U5: ISP1807-LR-RS; BULETM-SMD_ISP1807; LCSC C5264268
U6: BQ25101YFPR; DSBGA-6_L0.9-W1.6-R2-C3-P0.40-BL; LCSC C478468
U7: TLV75518PDQNR; X2SON-4_L1.0-W1.0-P0.65-TL-EP; LCSC C2867154

Connections:
AFE_INT: R5.2, U1.B2 (~INT), U5.48 (P0_28AIN4)
ANT: U5.20 (OUT_ANT), U5.22 (OUT_MOD)
CHG_STAT: U5.6 (P0_26), U6.C1 (~CHG)
GND: BT1.1, C1.2, C2.2, C3.2, C4.2, C5.2, C6.2, C7.2, C8.2, C9.2, C10.2, C11.2, C12.2, C13.2, C14.2, C15.2, C16.2, CP1.1, D1.2, Q1.1 (G), R6.2, R7.2, R9.2, SWD4.1, U1.B3 (GPIO1), U1.B4 (GPIO2), U1.C3 (GND_DIG), U1.C4 (GND_ANA), U1.C5 (PD_GND), U1.D3 (PGND), U2.2 (BPA), U2.10 (IPA), U3.1 (SDO), U3.6 (GNDIO), U3.7 (GND), U4.2 (GND), U4.4 (ADD0), U5.1 (VSS), U5.7 (VSS), U5.12 (VBUS), U5.14 (VSS), U5.16 (VSS), U5.18 (VSS), U5.21 (VSS), U5.23 (VSS), U5.24 (VSS), U5.25 (VSS), U5.31 (VSS), U6.C2 (VSS), U7.2 (GND), U7.5 (EP)
I2C_SCL: R3.2, U3.13 (SCX), U4.1 (SCL), U5.34 (P0_06)
I2C_SDA: R4.2, U3.14 (SDX), U4.6 (SDA), U5.36 (P0_05AIN3)
IMU_INT: U3.4 (INT1), U5.32 (P0_08)
ISET: R6.1, U6.B2 (ISET)
LED1: R1.2, R2.2, U1.D1 (LED1_DRV)
LED1_G1: R1.1, U2.6 (G1C)
LED1_G2: R2.1, U2.12 (G2C)
LED2: U1.C1 (LED2_DRV), U2.8 (RC)
LED3: U1.B1 (LED3_DRV), U2.9 (IC)
PD1_IN: U1.D5 (PD1_IN), U2.1 (BPC)
PD2_IN: U1.D4 (PD2_IN), U2.3 (IPC)
SPI_CS: U1.A5 (CSB), U5.46 (P0_29AIN5)
SPI_MISO: U1.A3 (SDO), U5.42 (P0_31AIN7)
SPI_MOSI: U1.A4 (SDI), U5.44 (P0_30AIN6)
SPI_SCK: U1.A2 (SCLK), U5.40 (P0_02AIN0)
SWDCLK: SWD3.1, U5.30 (SWDCLK)
SWDIO: SWD2.1, U5.28 (SWDIO)
TS: R7.1, U6.B1 (TS)
V18: C1.1, C2.1, C4.1, C7.1, C8.1, C9.1, C13.1, C14.1, C15.1, R3.1, R4.1, R5.1, SWD1.1, U1.C2 (VDD_DIG), U1.D2 (VDD_ANA), U3.2 (ASDX), U3.3 (ASCX), U3.5 (VDDIO), U3.8 (VDD), U3.12 (CSB), U4.5 (V+), U5.26 (VCC_nRF), U7.1 (OUT)
VBAT: BT2.1, C5.1, C6.1, C11.1, C12.1, R8.1, U1.A1 (VLED), U2.4 (IA), U2.5 (G1A), U2.7 (RA), U2.11 (G2A), U6.A1 (OUT), U7.3 (EN), U7.4 (IN)
VBAT_SENSE: C16.1, R8.2, R9.1, U5.38 (P0_03AIN1)
VIN_CHG: C10.1, Q1.2 (S), U6.A2 (IN)
VIN_RAW: CP2.1, D1.1, Q1.3 (D)
VREF: C3.1, U1.B5 (VREF)

Notes on the sheet:
VDD_ANA bypass
VDD_ANA bulk
VREF decoupling
VDD_DIG bypass
VLED bulk
VLED bypass
INT pull-up
ballast, green 1
ballast, green 2
BMI270 VDD
BMI270 VDDIO
TMP117 supply
I2C pull-up
module supply
divider filter
battery divider
charger input
charger output
charge current, about 10 mA
no thermistor on the cell
LDO input
LDO output
Pads: CP1/CP2 charge lands on the skin side, under the SMD spring contacts, BT1/BT2 cell tabs (polarity to confirm on the cell), SWD1..4 programming
Caseback V0.1 - netlist drawing generated from netlist_v01.py. Unused pads of the module are left out of its symbol.
U5 pin names and the supply range are from the LCSC symbol: check them against the ISP1807 datasheet before ordering.

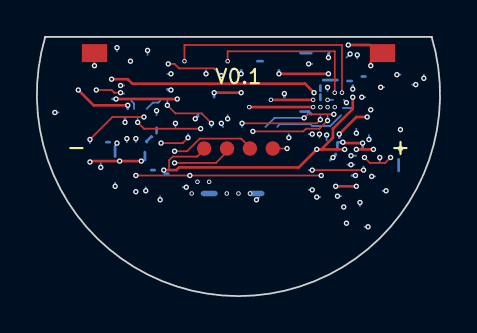
[picture p54: board caseback_v01.kicad_pcb from above]

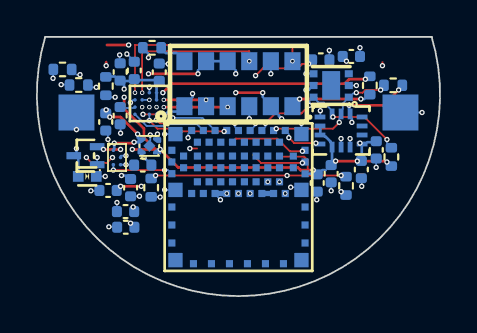
[picture p55: board caseback_v01.kicad_pcb from below]

Board: 4 copper layers, 22.4 x 14.4 mm, 42 parts (36 on the bottom side), 28 nets.
