raaulalonso/caseback/(commit log)

2026-10-30 publish: how Caseback is built (2026-10-30, How it's worn)
    The web: the home intro starts once the disc model is ready, and How it's
    worn draws the watch, the charger and the band in lines round the 3D disc.
    Generated from the private working repository by publish/export.py.
2026-10-30 publish: how Caseback is built (2026-10-30, slower motion, charger without the watch)
    The web: a slower home intro and hovers (the disc turns over to its pad, The
    app sends rings), and How it's worn slower, with the charger seen from above
    without the watch and the names shown on phones too.
    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
2026-10-31 publish: how Caseback is built (2026-10-31, home hovers, phone timing)
    The web: new hovers on the home (How it's worn draws the watch round the disc,
    The app sends the readings along its line), no hover on a tap, and How it's
    worn finishing each plate sooner on a phone.
    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
