raaulalonso/caseback/(notices)

Notices in the files:
README.md:
Source-available license
Open source license
